DaveyGraham/Peiriant_Par/Schematic.png

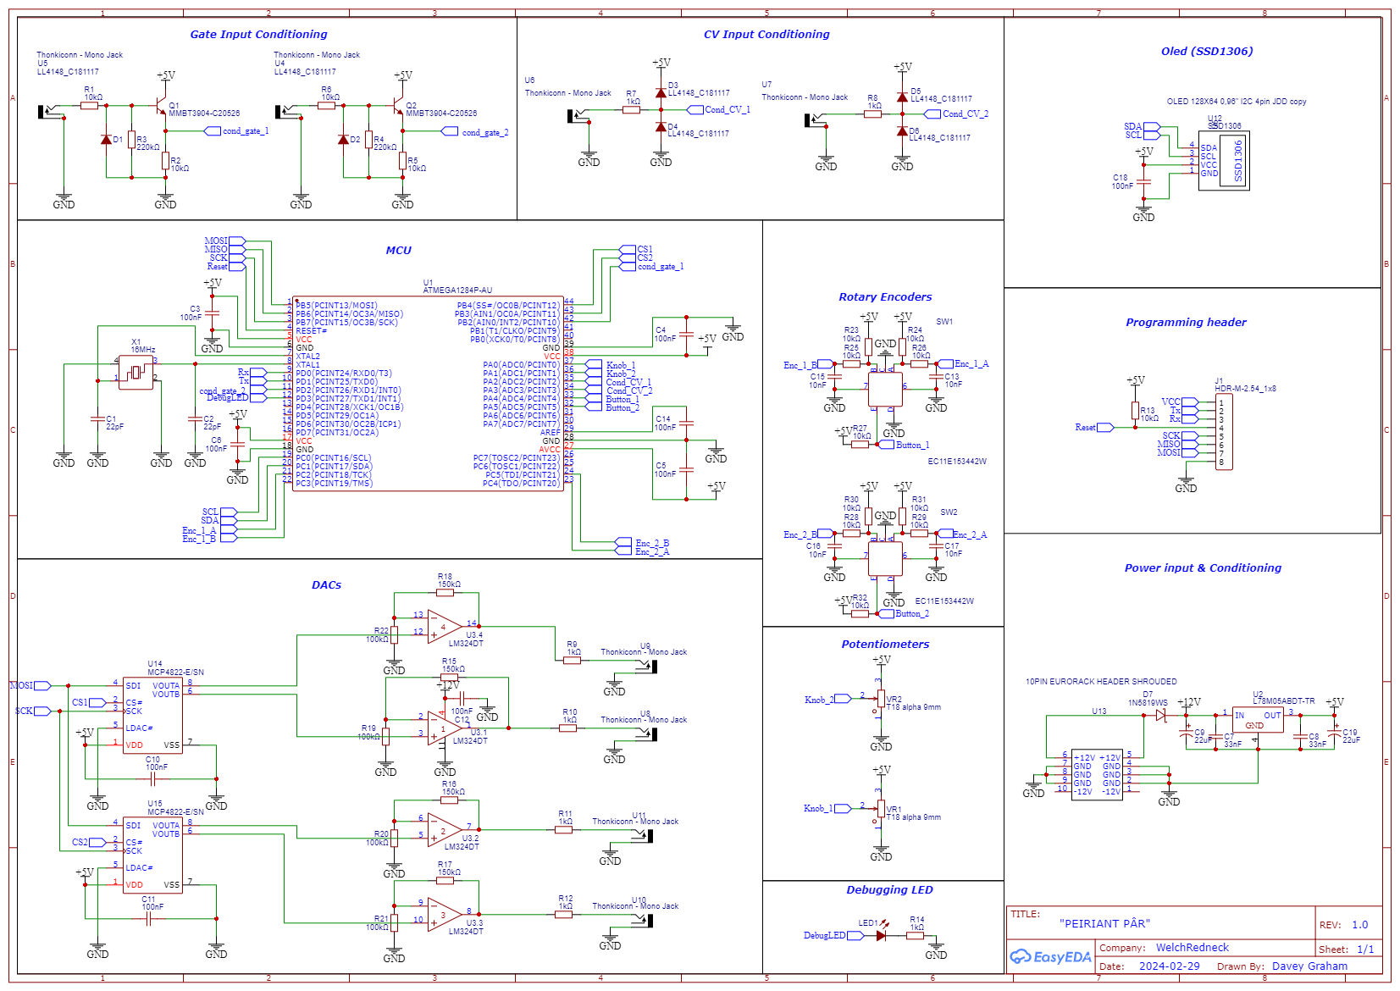
Schematic.png
