DaveyGraham/Peiriant_Par/(list of files, drawings)

Other design files:
PCB_PCB_Doohickey_for_phys_comp_MCP_change_2024-03-30.json
