DaveyGraham/Peiriant_Par/(threads)

Thread 1 (2024-04-01):

Interrupt issues

DaveyGraham, 2024-04-01:
The clock triggers an ISR to send CV and gates, which needs to be fast to avoid interrupting user inputs (reading encoders and pots).

I made a change to the design to use DACS for the gate outputs instead of digital outs to make it more versatile and have accented notes. Setting these gate DAC values in the ISR is slowing down the performance so a new solution needs to be figured out.
